DaviBarbosaMedeiros/Spring-Mass-Collector/docs/assets/images/1.3.2-Estruturta_DiscoZoom.png

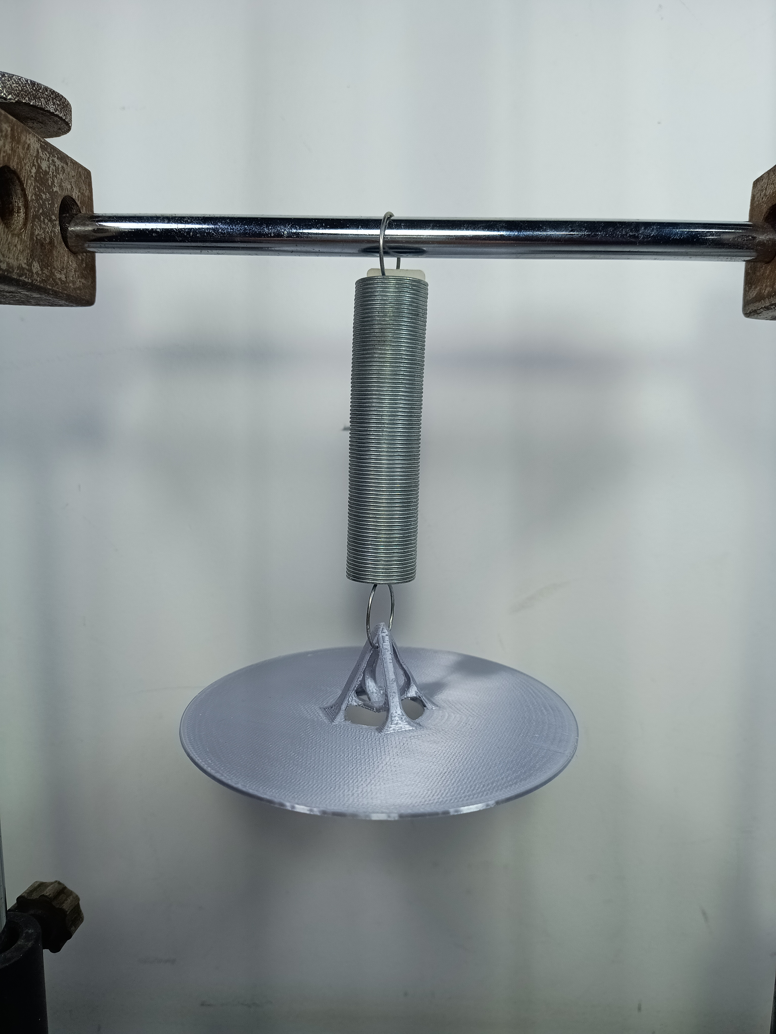
docs/assets/images/1.3.2-Estruturta_DiscoZoom.png
