DaviBarbosaMedeiros/Spring-Mass-Collector/docs/assets/images/6.1-Eletrônica_Button.png

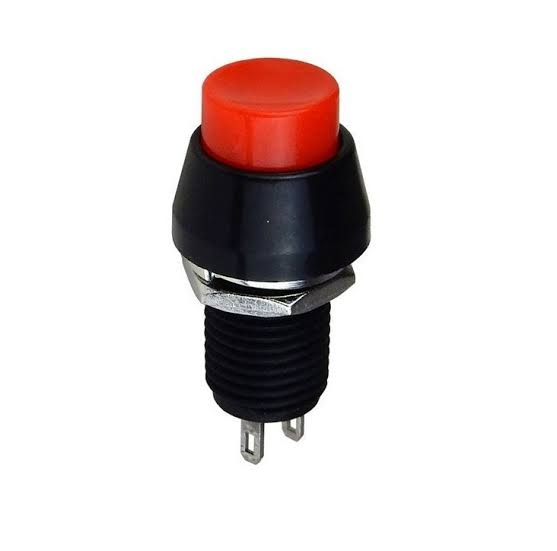
docs/assets/images/6.1-Eletrônica_Button.png
