DaviBarbosaMedeiros/Spring-Mass-Collector/docs/assets/images/6.2-Eletrônica_Microcontroller.png

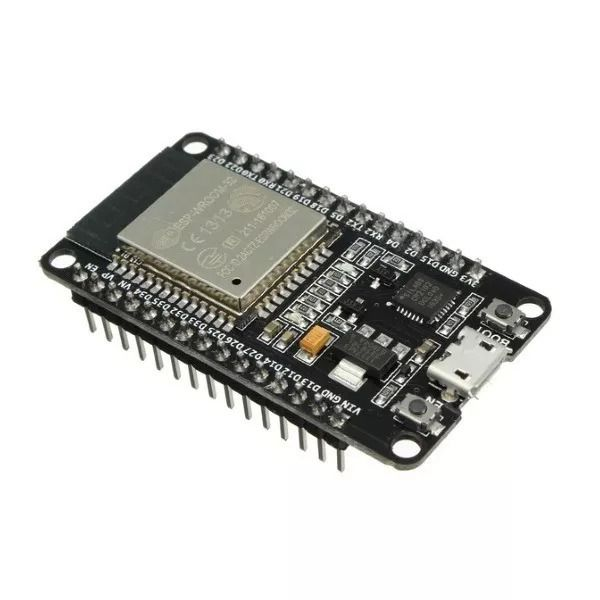
docs/assets/images/6.2-Eletrônica_Microcontroller.png
