DaviBarbosaMedeiros/Spring-Mass-Collector/docs/assets/images/6.3-Eletrônica_Display.png

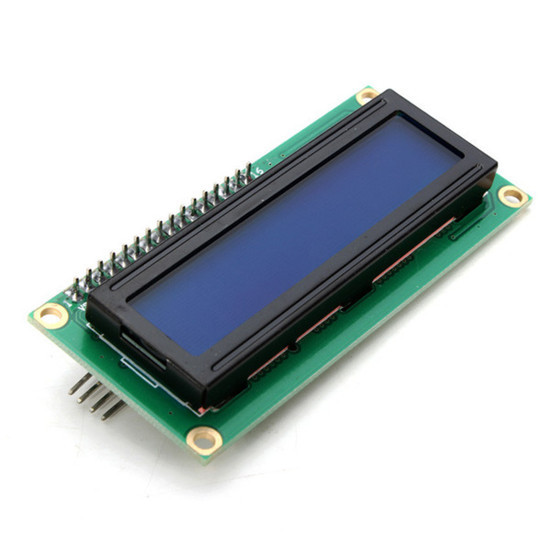
docs/assets/images/6.3-Eletrônica_Display.png
