DaviBarbosaMedeiros/Spring-Mass-Collector/docs/assets/images/6.4-Eletrônica_Sensor.png

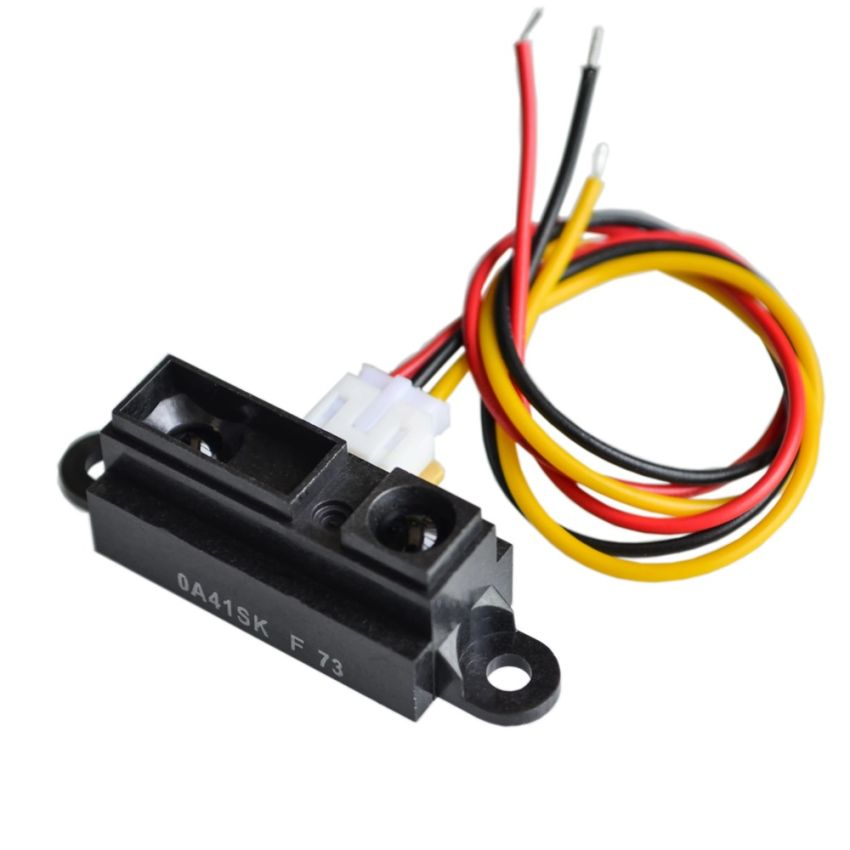
docs/assets/images/6.4-Eletrônica_Sensor.png
