DaviBarbosaMedeiros/Spring-Mass-Collector/docs/3D-Models/Estrutura(M).stl

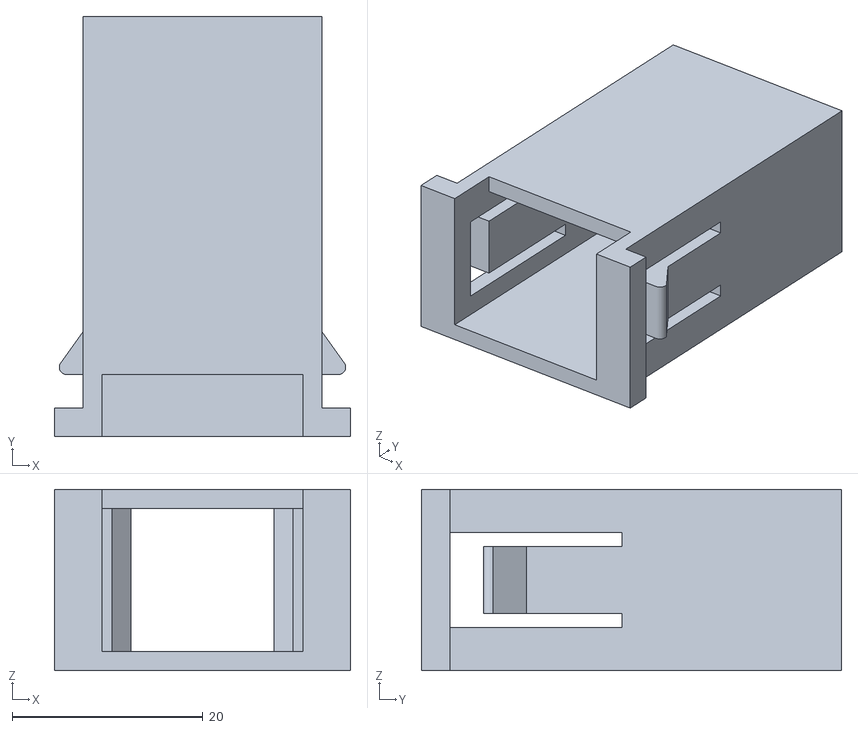
[picture p15: CAD file, 2026-07-17]
docs/3D-Models/Estrutura(M).stl
31.0 x 44.0 x 19.0
