DaviBarbosaMedeiros/Spring-Mass-Collector/docs/3D-Models/Corpo.stl

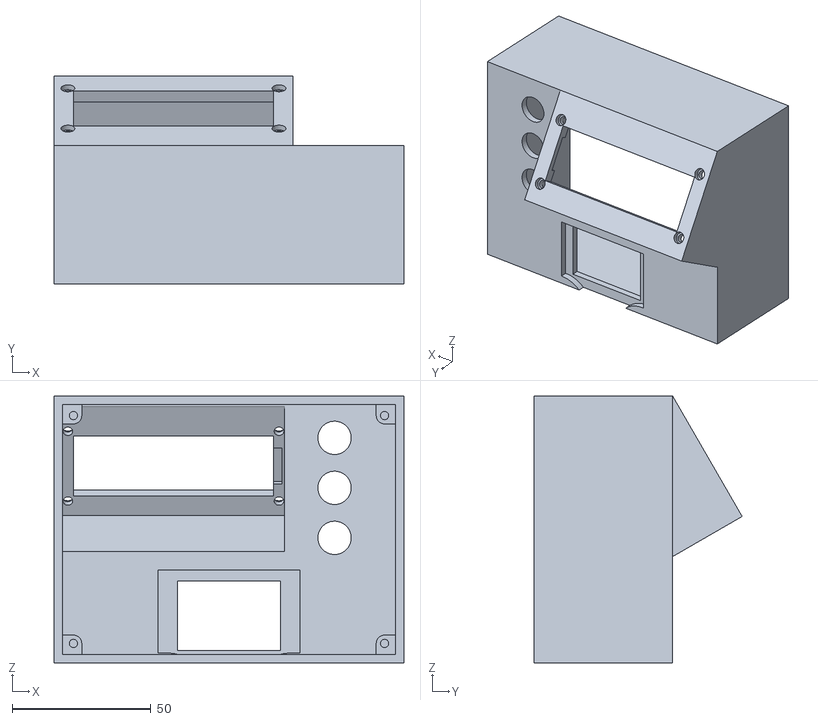
[picture p16: CAD file, 2026-07-17]
docs/3D-Models/Corpo.stl
126.0 x 75.0 x 96.0
