DaviBarbosaMedeiros/Spring-Mass-Collector/docs/3D-Models/Base.stl

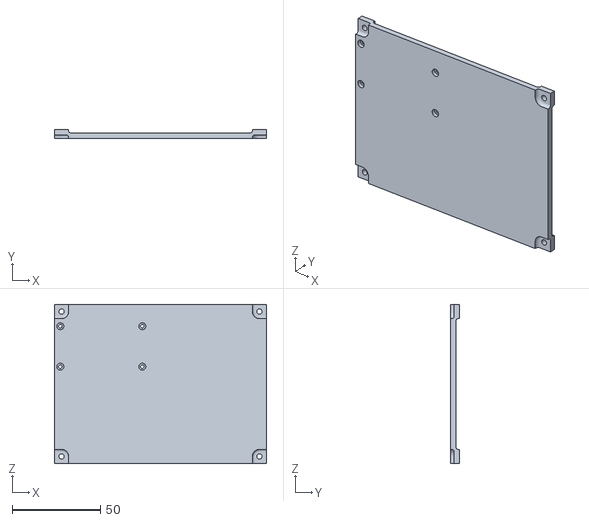
[picture p17: CAD file, 2026-07-17]
docs/3D-Models/Base.stl
120.0 x 5.00 x 90.0
