DaviBarbosaMedeiros/Spring-Mass-Collector/docs/3D-Models/Estrutura(P).stl

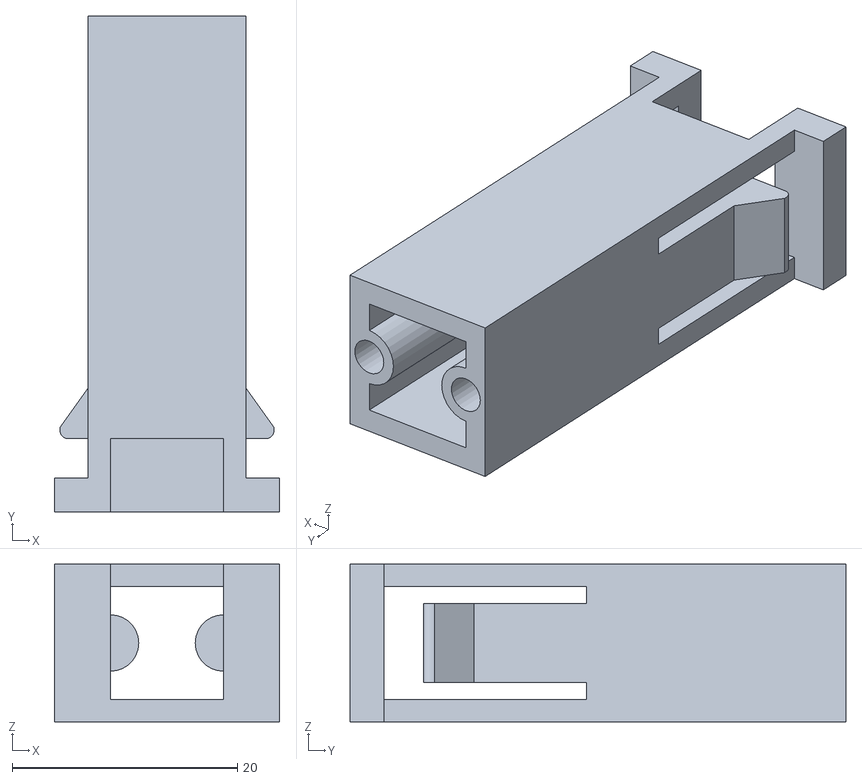
[picture p18: CAD file, 2026-07-17]
docs/3D-Models/Estrutura(P).stl
20.0 x 44.0 x 14.0
