DaviBarbosaMedeiros/Spring-Mass-Collector/docs/3D-Models/Estrutura(G).stl

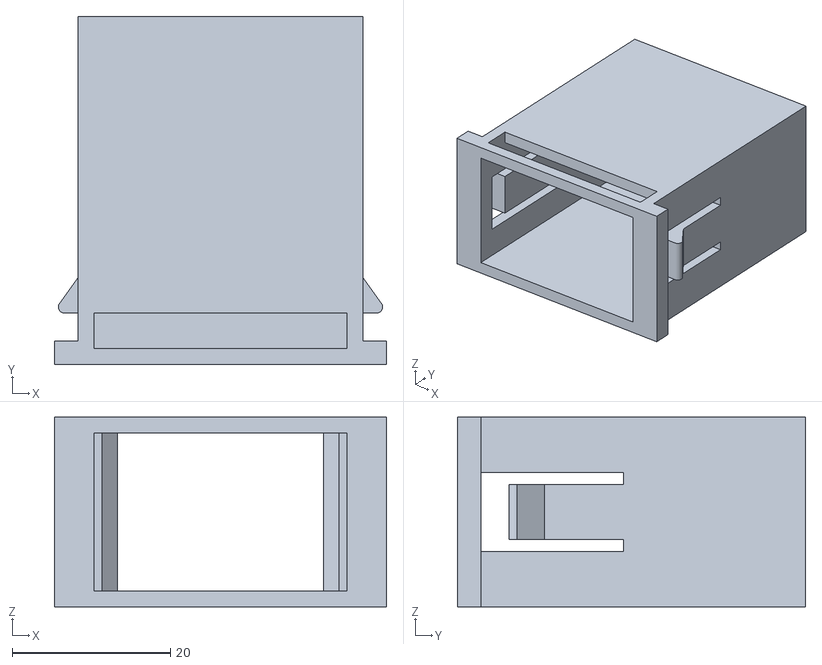
[picture p19: CAD file, 2026-07-17]
docs/3D-Models/Estrutura(G).stl
42.0 x 44.0 x 24.0
