DaviBarbosaMedeiros/Spring-Mass-Collector/docs/3D-Models/Disco.stl

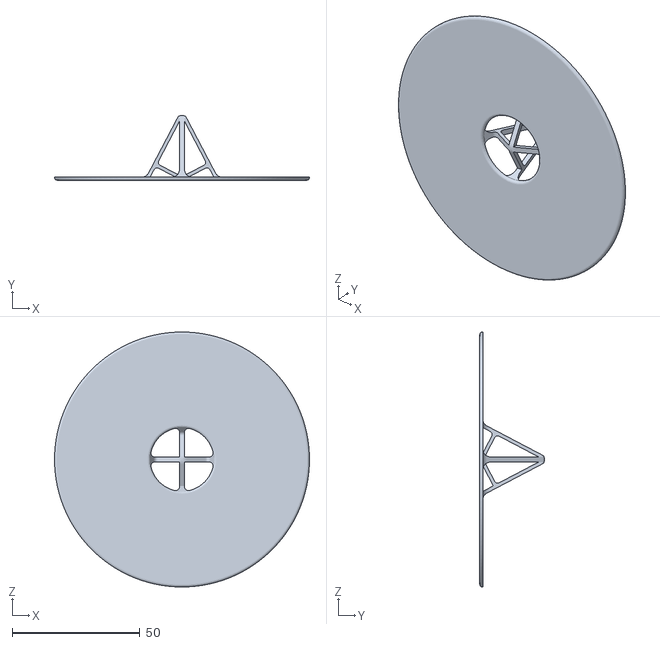
[picture p20: CAD file, 2026-07-17]
docs/3D-Models/Disco.stl
100.0 x 25.3 x 100.0
