DaviBarbosaMedeiros/Spring-Mass-Collector/docs/developer-guide/budget.md

# Budget

A tabela apresenta uma estimativa simplificada do custo para construir uma unidade do Spring-Mass Collector.

Os valores podem variar conforme fornecedor, região e frete.

| Material | Quantidade | Valor médio |
| --- | ---: | ---: |
| ESP32 DevKit de 30 pinos | 1 | R$ 40,00 |
| Sensor Sharp GP2Y0A41SK0F | 1 | R$ 50,00 |
| Display LCD 16×2 com I²C | 1 | R$ 23,00 |
| Botões de pressão | 3 | R$ 9,00 |
| Fios e cabos jumper | 1 conjunto | R$ 10,00 |
| Placa de prototipagem perfurada | 1 | R$ 12,00 |
| Cabo USB de dados | 1 | R$ 15,00 |
| Filamento PLA de 1 kg | 1 rolo | R$ 100,00 |
| Material refletivo para o disco | 1 | R$ 5,00 |
| Insertos roscados M3 | 4 | R$ 4,00 |
| Parafusos M3 | 4 | R$ 4,00 |
| Insertos roscados M2 | 2 | R$ 2,00 |
| Parafusos M2 | 2 | R$ 2,00 |
| Parafusos para o LCD | 4 | R$ 4,00 |
| Materiais de soldagem e isolamento | — | R$ 20,00 |
| Fixadores ou conectores adicionais | — | R$ 4,00 |
| **Total estimado** | | **R$ 304,00** |

!!! note "Filamento"
O orçamento considera a compra de um rolo completo de PLA de 1 kg. Apenas parte do material será consumida na fabricação das peças.

---

## Itens não incluídos

O orçamento não inclui:

* impressora 3D;
* computador;
* smartphone;
* ferramentas;
* estrutura do experimento;
* molas e massas;
* frete;
* mão de obra.

Esses itens são considerados parte da infraestrutura disponível no laboratório ou ambiente de desenvolvimento.
