DaviBarbosaMedeiros/Spring-Mass-Collector/docs/mechanical-design/assembly.md

# Assembly

A montagem da estrutura do Spring-Mass Collector deve ser realizada em etapas, começando pela instalação dos insertos roscados e pela união dos suportes impressos em 3D.

A tampa inferior da caixa somente deve ser instalada após a montagem do sistema eletrônico, pois o interior da caixa precisa permanecer acessível para a instalação dos componentes e a organização dos fios.

---

## Componentes necessários

Para a montagem mecânica, são necessários:

| Componente | Quantidade | Aplicação |
| --- | ---: | --- |
| Inserto roscado M3 | 4 | fixação da tampa inferior da caixa |
| Inserto roscado M2 | 2 | fixação do suporte do sensor |
| Parafuso M3 | 4 | fechamento da tampa inferior |
| Parafuso M2 | 2 | união entre o suporte superior e o suporte do sensor |
| Caixa | 1 | corpo principal do equipamento |
| Suporte base | 1 | primeiro estágio da estrutura extensível |
| Suporte intermediário | 1 | estágio intermediário da extensão |
| Suporte superior | 1 | estágio superior da extensão |
| Suporte do sensor | 1 | fixação do sensor na extremidade da estrutura |
| Tampa inferior | 1 | fechamento da caixa |

!!! note "Compatibilidade"
Antes da montagem, confirme se os parafusos, insertos e furos das peças possuem dimensões compatíveis. O uso de um inserto maior do que o alojamento pode trincar ou deformar a peça impressa.

---

## Preparação das peças

Antes de inserir os elementos de fixação, verifique:

* se não existem resíduos de impressão nos encaixes;
* se as travas mecânicas conseguem se movimentar;
* se os furos para os insertos estão livres;
* se as passagens dos fios não estão obstruídas;
* se não existem trincas ou separações entre camadas;
* se a tampa inferior está alinhada com a caixa.

Pequenos excessos de material podem ser removidos cuidadosamente antes da montagem.

!!! warning "Ajustes nos encaixes"
Não force a união das peças. Caso um encaixe esteja excessivamente apertado, identifique a região de contato e remova apenas o material necessário. O desgaste excessivo pode produzir folgas permanentes.

---

## Instalação dos insertos roscados

Os insertos devem ser instalados antes da união dos suportes e da montagem dos componentes eletrônicos.

### Insertos M3 da caixa

Instale quatro insertos roscados M3 nos alojamentos localizados nas quatro extremidades inferiores da caixa.

Esses insertos serão utilizados posteriormente para fixar a tampa inferior.

A instalação deve manter cada inserto:

* centralizado no alojamento;
* perpendicular à superfície;
* nivelado com a região de apoio;
* firmemente preso ao material da caixa.

### Insertos M2 do suporte superior

Instale dois insertos roscados M2 nos alojamentos do suporte superior.

Eles serão utilizados para fixar o suporte do sensor ao suporte superior.

!!! warning "Instalação com aquecimento"
Caso os insertos sejam instalados com um ferro de solda, aplique apenas o calor necessário para amolecer o material ao redor do alojamento. Pressão ou temperatura excessivas podem deformar a peça.

Durante a inserção:

1. posicione o inserto sobre o alojamento;
2. mantenha-o alinhado com o furo;
3. aqueça e pressione lentamente;
4. interrompa a pressão quando atingir a profundidade correta;
5. aguarde o resfriamento antes de testar o parafuso.

Não rosqueie os parafusos enquanto o material ainda estiver quente.

---

## Etapa 1 — União do suporte superior com o suporte intermediário

Encaixe o suporte superior dentro do suporte intermediário.

Esse primeiro conjunto será denominado **Conjunto 01**.

```text
Suporte superior
        ↓
Suporte intermediário
        ↓
Conjunto 01
```

Durante o encaixe:

* alinhe as faces das duas peças;
* mantenha as travas afastadas das paredes internas;
* confirme que os fios poderão atravessar o interior;
* não pressione diretamente as regiões flexíveis;
* verifique se o suporte superior desliza sem inclinação.

Após o encaixe, teste o mecanismo de extensão pressionando simultaneamente os dois lados das travas.

!!! warning "Travas mecânicas"
Não tente deslocar os suportes enquanto as travas estiverem completamente encaixadas. Pressione os dois lados simultaneamente antes de alterar a extensão.

---

## Etapa 2 — União do Conjunto 01 com o suporte base

Encaixe o Conjunto 01 dentro do suporte base.

O resultado será denominado **Conjunto 02**.

```text
Conjunto 01
      ↓
Suporte base
      ↓
Conjunto 02
```

Antes de concluir o encaixe, observe a posição da barra inferior utilizada como guia para os fios.

A estrutura deve permitir que os fios atravessem os suportes sem:

* passar pelas travas;
* ficar pressionados entre as paredes;
* formar dobras acentuadas;
* impedir o movimento da extensão;
* sofrer tensão quando a altura for alterada.

Após a união, verifique se os três suportes permanecem alinhados.

---

## Etapa 3 — Instalação do Conjunto 02 na caixa

Encaixe o Conjunto 02 na região da caixa destinada ao suporte base.

O resultado será denominado **Conjunto 03**.

```text
Conjunto 02
      ↓
Região de suporte da caixa
      ↓
Conjunto 03
```

Durante essa etapa:

1. alinhe o suporte base com a abertura correspondente;
2. direcione os fios para o interior da caixa;
3. introduza o suporte gradualmente;
4. confirme que nenhuma conexão ficou presa;
5. pressione até que a peça alcance sua posição final.

O suporte base deve permanecer perpendicular à caixa, sem inclinação lateral significativa.

!!! warning "Passagem dos fios"
Os fios devem ser direcionados para o interior da caixa durante o encaixe. Não finalize a conexão caso algum fio esteja comprimido entre o suporte base e a parede da caixa.

---

## Etapa 4 — Fixação do suporte do sensor

Posicione o suporte do sensor sobre a região de fixação do suporte superior.

Alinhe os furos do suporte do sensor com os dois insertos M2 instalados anteriormente.

Fixe as peças utilizando dois parafusos M2.

O resultado será denominado **Conjunto 04**.

```text
Suporte do sensor
        ↓
Suporte superior
        ↓
Dois parafusos M2
        ↓
Conjunto 04
```

Aperte os parafusos alternadamente para distribuir a pressão entre os dois lados.

O suporte do sensor deve permanecer:

* centralizado;
* alinhado com a estrutura;
* sem movimento lateral;
* sem deformação;
* com a passagem dos fios livre.

!!! warning "Torque dos parafusos"
Não aplique aperto excessivo. Os parafusos devem eliminar a folga entre as peças sem deformar o suporte do sensor ou deslocar os insertos.

---

## Verificação da estrutura extensível

Antes de instalar o sistema eletrônico, teste o funcionamento mecânico do conjunto.

Pressione simultaneamente as travas e movimente a extensão entre os níveis disponíveis.

Verifique:

* se os suportes deslizam sem travar;
* se as travas retornam à posição inicial;
* se cada nível permanece fixo;
* se os fios acompanham o movimento;
* se o suporte do sensor permanece alinhado;
* se a caixa continua estável;
* se não existem folgas excessivas.

!!! danger "Teste sem forçar"
Interrompa o teste caso seja necessário aplicar força elevada. A resistência pode indicar desalinhamento, excesso de material ou um fio preso entre os suportes.

---

## Montagem do sistema eletrônico

Após a montagem da estrutura extensível, o interior da caixa deve permanecer aberto para a instalação do sistema eletrônico.

Nessa etapa, devem ser montados e conectados:

* microcontrolador;
* display LCD;
* botões;
* sensor de distância;
* fios e conectores;
* demais elementos de fixação.

A montagem eletrônica deve seguir as conexões apresentadas na página [Schematic](../electronics/schematic.md).

Durante a instalação, organize os fios de modo que:

* não sejam pressionados pela tampa;
* não bloqueiem a abertura lateral;
* não fiquem tensionados;
* não interfiram nos botões;
* não pressionem o display;
* não entrem em contato com as travas;
* permitam movimentar a extensão.

!!! info "Teste antes do fechamento"
Ligue o sistema e verifique o display, os botões, o sensor e a comunicação antes de instalar a tampa inferior. Corrigir uma conexão depois do fechamento exige desmontar novamente a caixa.

---

## Organização interna

Antes de fechar a caixa, confirme que todos os componentes estão corretamente posicionados.

Os fios devem ser distribuídos pelo espaço interno, evitando acúmulo sobre:

* insertos M3;
* bordas da tampa;
* conectores;
* partes móveis;
* aberturas externas.

A tampa deve alcançar sua posição final sem precisar comprimir os componentes internos.

!!! warning "Fechamento sob pressão"
Não utilize os parafusos para forçar a tampa contra fios ou componentes. Caso a tampa não encoste corretamente na caixa, reabra o conjunto e reorganize o interior.

---

## Fechamento da caixa

Após concluir e testar a montagem eletrônica, posicione a tampa inferior sobre a caixa.

Alinhe os quatro furos da tampa com os quatro insertos M3 instalados nas extremidades inferiores.

Introduza os quatro parafusos M3 sem apertá-los completamente.

Aperte-os gradualmente em sequência cruzada:

```text
1 ───────── 3
│           │
│           │
4 ───────── 2
```

Esse procedimento distribui a pressão e reduz a possibilidade de desalinhamento da tampa.

O aperto deve ser suficiente para manter a tampa fechada, sem deformar a caixa.

---

## Inspeção final

Após concluir a montagem, verifique:

* fixação da tampa inferior;
* alinhamento dos suportes;
* funcionamento das travas;
* fixação do suporte do sensor;
* acesso à abertura lateral;
* leitura do display;
* funcionamento dos botões;
* passagem adequada dos fios;
* estabilidade da caixa;
* ausência de componentes soltos.

Movimente cuidadosamente a estrutura extensível e confirme que os fios não são tensionados em nenhum dos níveis.
