DaviBarbosaMedeiros/Spring-Mass-Collector/(commit log)

2026-06-10 Adicao de imagens
2026-07-08 Mudanças a serem submetidas: modified: .github/workflows/ci.yml new file: docs/assets/images/caixa.jpg deleted: docs/budget.md new file: docs/developer-guide/build-and-deploy.md new file: docs/develo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
2026-07-17 Update documentation
    [Base.stl, Corpo.stl, Disco.stl, Estrutura(G).stl, Estrutura(M).stl, Estrutura(P).stl]
